i-n-g-o/intrabody-PAN/README.md

# intrabody-PAN
a near-field intra-body Communication Device

more info: http://ingorandolf.info/building-a-near-field-intra-body-communication-device/
