i-n-g-o/intrabody-PAN/kicad/pan.sch

## KiCad design kicad/pan.sch (2018-04-13)

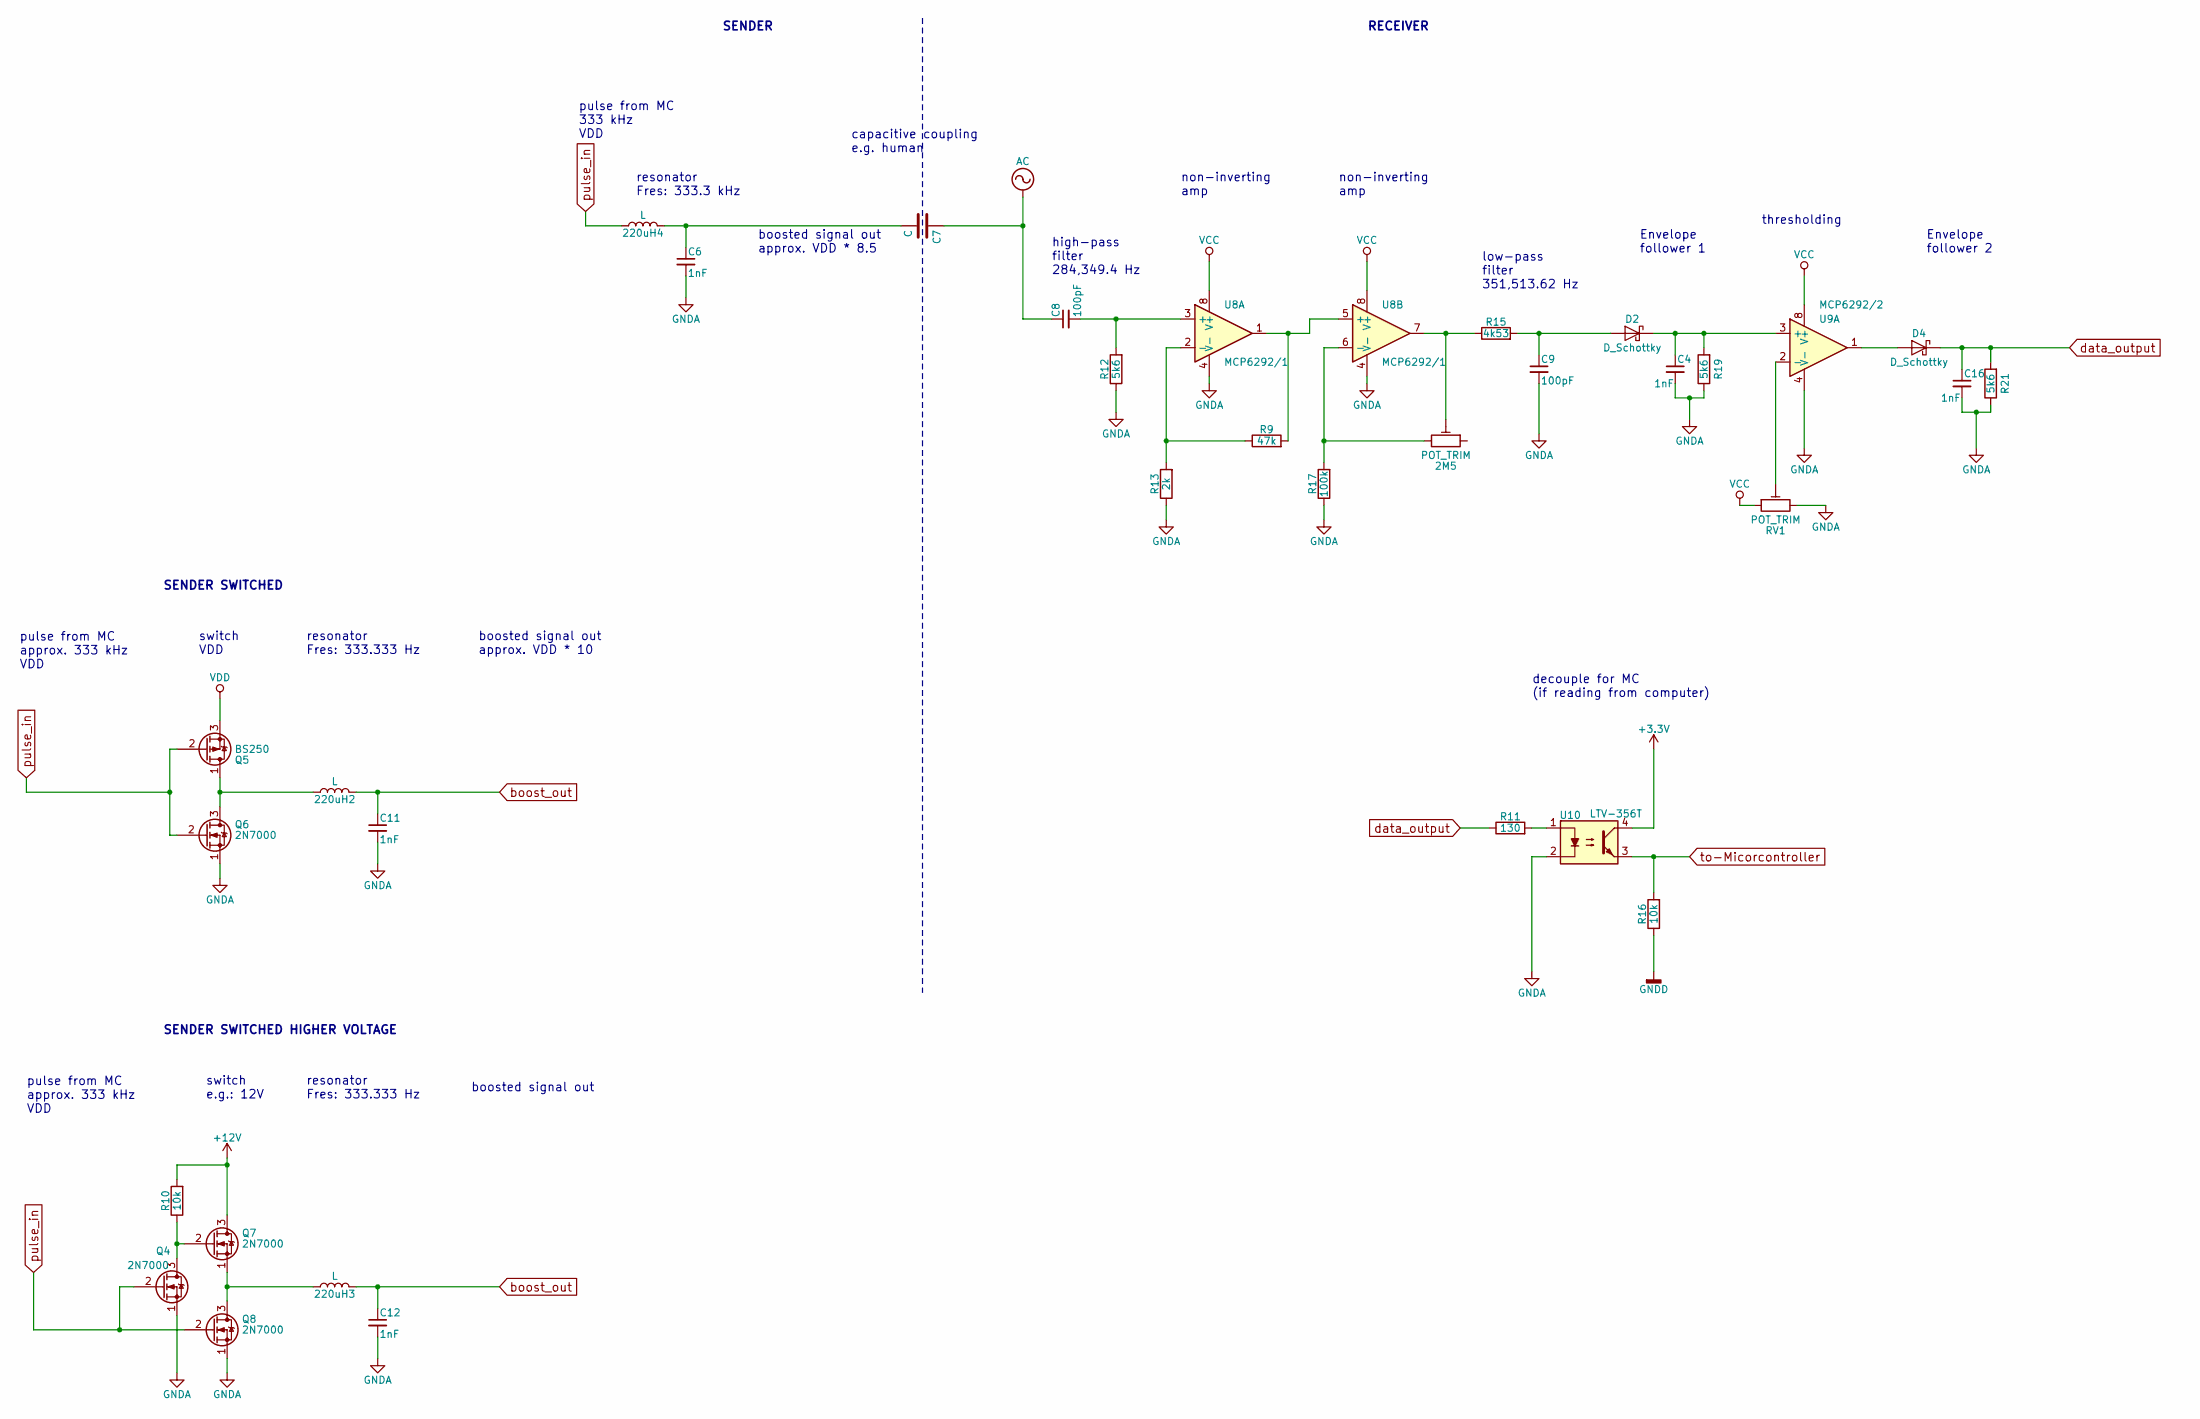
[picture p1: schematic pan.sch]

Parts:
2M5: POT_TRIM
220uH2, 220uH3, 220uH4: L
C4, C6, C11, C12, C16: 1nF
C7: C
C8, C9: 100pF
D2, D4: D_Schottky
Q4, Q6, Q7, Q8: 2N7000; TO-92_Molded_Narrow
Q5: BS250; TO-92_Molded_Narrow
R9: 47k
R10, R16: 10k
R11: 130
R12, R19, R21: 5k6
R13: 2k
R15: 4k53
R17: 100k
RV1: POT_TRIM
U8: MCP6292/1
U9: MCP6292/2
U10: LTV-356T; SO-4_4.4x3.6mm_Pitch2.54mm

Connections:
+3.3V: U10.4
+12V: Q7.3 (D), R10.2
AC: C7.1, C8.1
GNDA: C4.2, C6.2, C9.2, C11.2, C12.2, C16.2, Q4.1 (S), Q6.1 (S), Q8.1 (S), R12.1, R13.1, R17.1, R19.1, R21.1, RV1.3, U8.4 (V-), U9.4 (V-), U10.2
GNDD: R16.1
unnamed: 2M5.2, R15.1, U8.7
unnamed: 2M5.3, R17.2, U8.6 (-)
unnamed: 220uH2.1, Q5.1 (D), Q6.3 (D)
unnamed: 220uH3.1, Q7.1 (S), Q8.3 (D)
unnamed: 220uH4.2, C6.1, C7.2
unnamed: C4.1, D2.1 (K), R19.2, U9.3 (+)
unnamed: C8.2, R12.2, U8.3 (+)
unnamed: C9.1, D2.2 (A), R15.2
unnamed: D4.2 (A), U9.1
unnamed: Q4.3 (D), Q7.2 (G), R10.1
unnamed: R9.2, U8.1, U8.5 (+)
unnamed: R11.2, U10.1
unnamed: R9.1, R13.2, U8.2 (-)
unnamed: RV1.2, U9.2 (-)
VCC: RV1.1, U8.8 (V+), U9.8 (V+)
VDD: Q5.3 (S)
boost_out: 220uH2.2, 220uH3.2, C11.1, C12.1
data_output: C16.1, D4.1 (K), R11.1, R21.2
pulse_in: 220uH4.1, Q4.2 (G), Q5.2 (G), Q6.2 (G), Q8.2 (G)
to-Micorcontroller: R16.2, U10.3

Notes on the sheet:
non-inverting amp
thresholding
capacitive coupling e.g. human
SENDER
RECEIVER
high-pass filter 284,349.4 Hz
low-pass filter 351,513.62 Hz
resonator Fres: 333.3 kHz
decouple for MC (if reading from computer)
pulse from MC approx. 333 kHz VDD
SENDER SWITCHED
resonator Fres: 333.333 Hz
boosted signal out approx. VDD * 10
switch VDD
SENDER SWITCHED HIGHER VOLTAGE
boosted signal out
switch e.g.: 12V
pulse from MC 333 kHz VDD
Envelope follower 1
Envelope follower 2
boosted signal out approx. VDD * 8.5
