i-n-g-o/intrabody-PAN/(commit log)

2018-04-13 add kicad-project, PAN-writer and PAN-arduino-read
    [pan.sch]
2018-07-25 add error-led, unset data-match led
    [PAN-arduino-read.ino]
2019-01-18 fix use of CircularBuffer
    [PAN-writer-attiny.ino]
